Dan-zanfira/Input-Audio-Preamplifier/Layout/pcb_layout.jpg

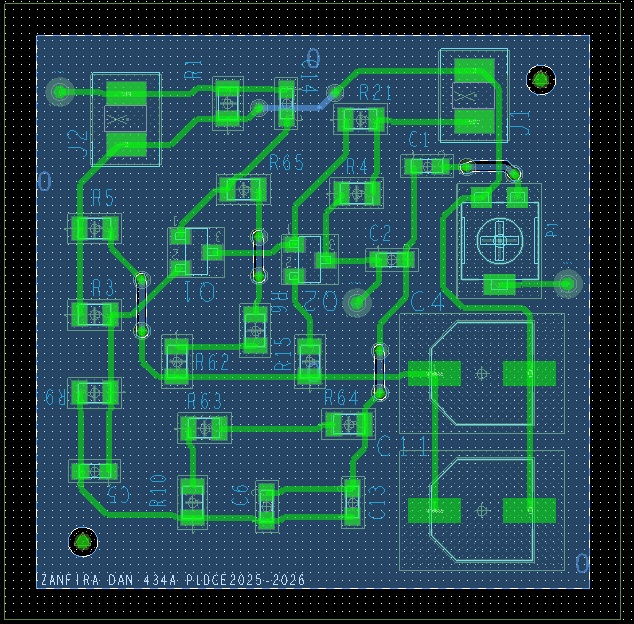
Layout/pcb_layout.jpg
