Dan-zanfira/Input-Audio-Preamplifier/Project docs/document ZANFIRA.pdf

Universitatea “Politehnica” din Bucuresti

Facultatea de Electronica , Telecomunicatii si Tehnologia Informatiei

# PROIECT 1

# PREAMPLIFICATOR AUDIO DE INTRARE

# CAPITOLUL 5

Student: ZANFIRA Dan-Constantin

Grupa:434A

Prof. coordonator: BABARADA Florin

## 1.TEMA DE PROIECTARE

Tema de proiectare reprezintă un preamplificator de audiofrecvență de intrare cu schema bloc din Figura 1.

Amplificatorul audio de intrare este compus dintr-o rețea de adaptare la intrare sursa de semnal audio fiind microfonul şi două etaje de amplificare în clasa A, respectiv etajul de intrare şi etajul de ieşire care realizează amplificarea în tensiune a semnalului.

Amplificarea globala a amplificatorului audio de intrare este stabilita de reactie negativa serie la intrare-paralel la iesire iar alimentarea celor doua etaje de amplificare este realizata de sursa de alimentare.

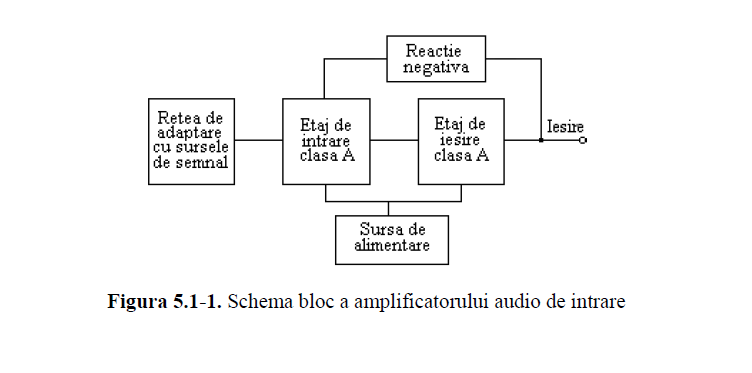
[picture p2: figure]

## 2.DATE DE INTRARE:

Principalii parametrii de intare ai amplificatorului audio sunt:
- Sensibilitatea minimă la intare Vin (2,5mV)
- Rezistența de intrare Rin(47 kOhm)
- Rezistența de ieșire maximă R0M(4 kOhm)
- Tensiunea nominală la ieșirea amplificatorului audio de putere Vn (1,4Vef)

Datele de intrare pentru proiectare sunt afisate mai jos:

Nr. | Preamplificator | Sursa de alimentare
Vin (mV) | Ri (KΩ) | R0M (KΩ) | Vn (Vef) | Io (mA) | R0M (Ω) | S0min (-)
5 | 2,5 | 47 | 4 | 1,4 | 12 | 6 | 80

## 3.SCHEMA ELECTRONICA:

Preamplificatorul este partea care influenteaza cel mai pregnant raportul semnal zgomot, caracteristica de frecventa si factorul de distorsiuni intr-un lant de amplificare de audiofrecventa.

In practica exista adesea şi alte semnale numite semnale false, care tind sa interfereze cu semnalele dorite şi acestea se numesc în general semnale de zgomot. Un obiectiv important în proiectare este realizarea unui bun raport semnal zgomot, cu toate ca zgomotul nu poate fi eliminat complet.

Un preamplificator sensibil si relativ putin zgomotos constituie o problema importanta dacă urmeaza ca la iesire zgomotul sa fie minim, deoarece orice zgomot din preamplificator este amplificat de fiecare etaj care urmeaza.

Din aceste considerente pentru intrarea microfon dinamic la care nivelul semnalului de intrare precum si raportul semnal zgomot sunt minime, sunt prevazute filtre de compensare care actioneaza prin intermediul sistemului de reactie negativa.

De asemenea, a fost introdus un filtru RC pe etajul de intrare pentru a reduce brumul de retea. Amplificarea în tensiune este realizată de etajul de intrare si cel de iesire.

Etajul de intrare este de tipul emitor comun cu sarcina distribuita si este realizat cu tranzistorul Q1. Etajul de ieşire este cuplat galvanic cu etajul de intrare si este de tip emitor comun, realizat cu tranzistorul Q2.

Având în vedere faptul că intrarea amplificatorului de putere necesită la intrare un semnal cu amplitudinea de 1,4 Vef, iar amplificatorul corector de ton sau alte etaje intermediare au amplificarea

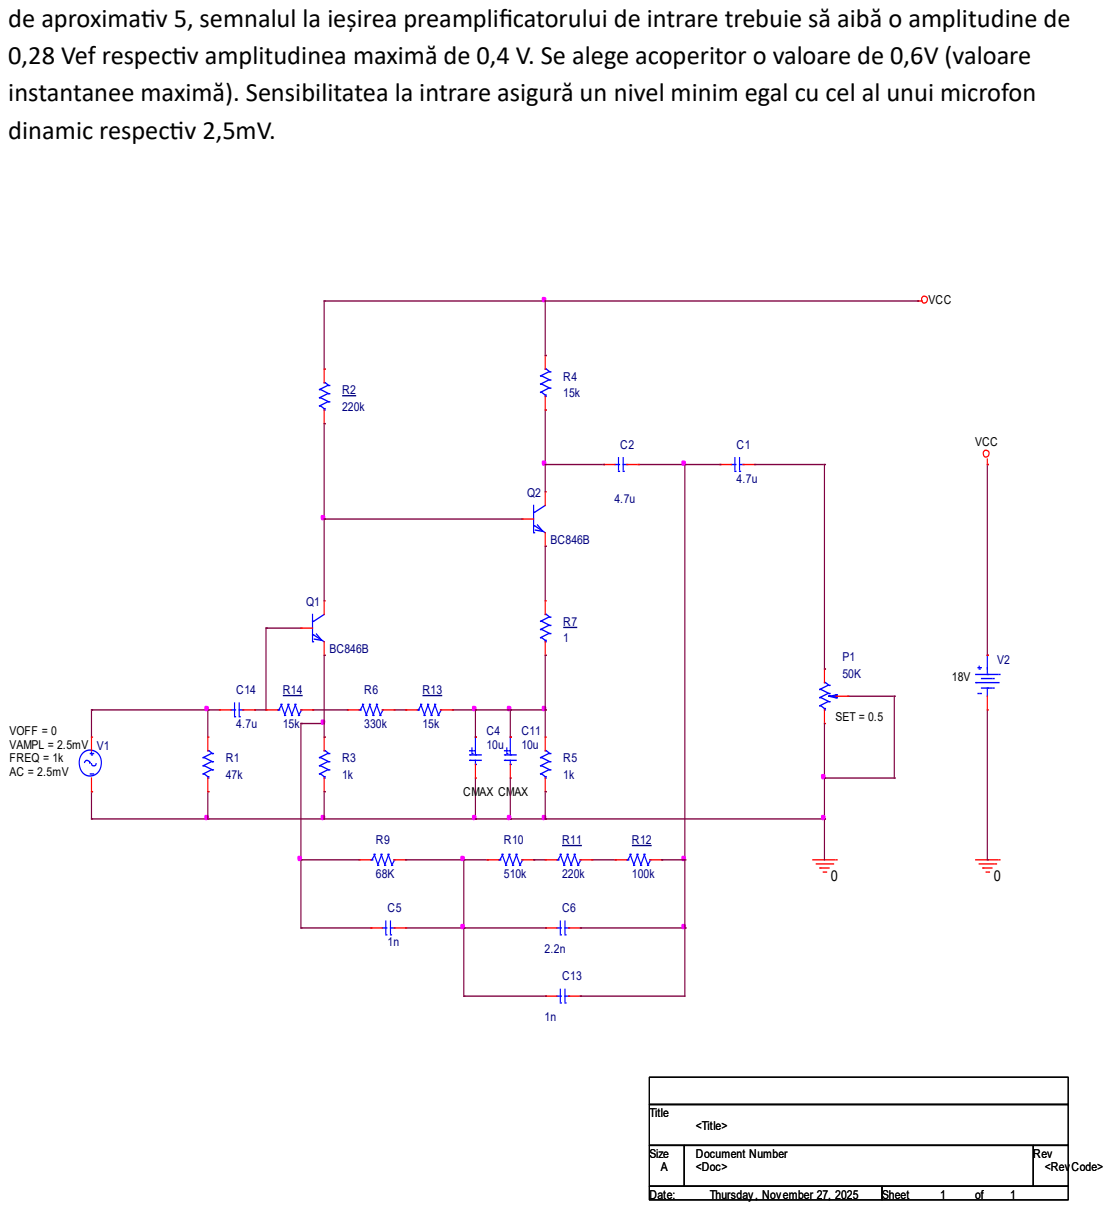
[picture p3: page 4]

de aproximativ 5, semnalul la ieşirea preamplificatorului de intrare trebuie să aibă o amplitudine de
0,28 Vef respectiv amplitudinea maximă de 0,4 V. Se alege acoperitor o valoare de 0,6V (valoare
instantanee maximă). Sensibilitatea la intrare asigură un nivel minim egal cu cel al unui microfon
dinamic respectiv 2,5mV.

## 4.ETAJELE DE AMPLIFICARE:

Avand în vedere faptul ca intrarea amplificatorului de putere necesita la intrare un semnal cu amplitudinea de 1,4 Vef, iar amplificatorul corector de ton sau alte etaje intermediare au amplificarea de aproximativ 5, semnalul la iesirea preamplificatorului de intrare trebuie sa aiba o amplitudine de 0,28 Vef respectiv amplitudinea maximă de 0,4 V. Sensibilitatea la intrare asigură un nivel minim egal cu cel al unui microfon dinamic respectiv 2,5mV.

1)Alegerea tranzistorilor Q1 si Q2:

Nivelul mic al semnalului de intrare impune alegerea pentru etajele de amplificare a unor tranzistoare cu zgomot mic de tip BC846B cu următoarele PSF-uri:

Pentru Q1, pe baza curbelor izo-F, din catalog pentru BC846B, se alege IC1 = 80 μA la care pentru rezistența generatorului Rg = 2 ÷ 20k ⇒ F ≤ 2dB. Se alege VCE1 ≅ 1,4 V. Din catalog în acest PSF rezultă:

hIE1 ≅ rBE1 ≅ 150 kΩ

hFE1 = β1 ≅ 300

hOE1 ≅ 18 μS

Pentru Q2 se alege IC2 ≅ 1mA şi VCE2 ≅ 8 V. Din catalog în acest PSF rezultă:

hIE2 ≅ rBE2 ≅ 11k

hFE2 = β2 ≅ 400

hOE2 ≅ 60 μS

2)Amplificarea in tensiune:

Amplificarea în tensiune a etajului de intrare care este de tipul emitor comun cu sarcină distribuită este:

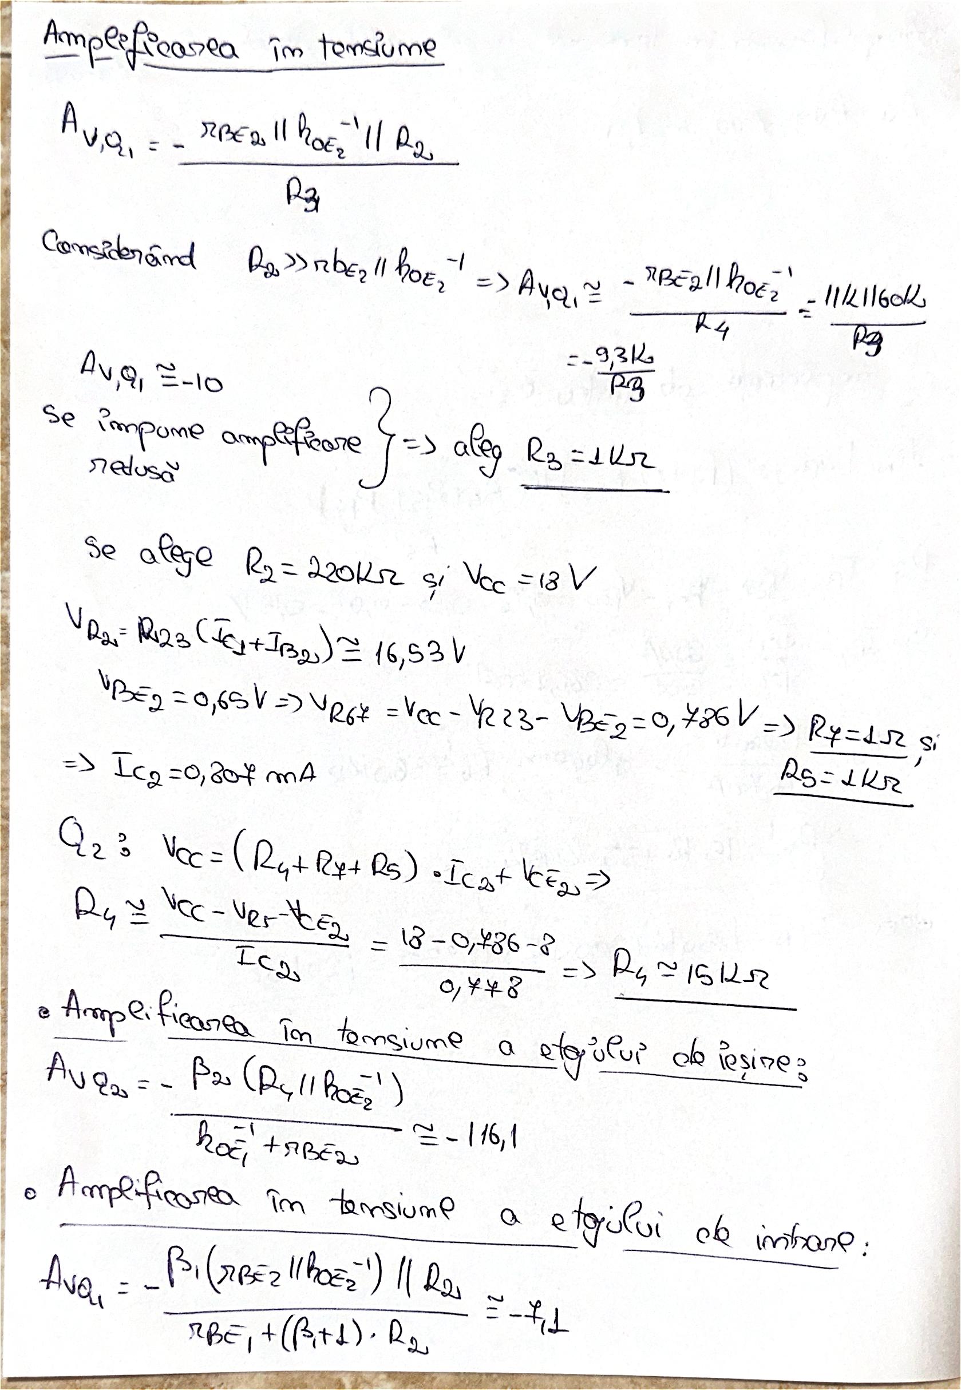
[picture p4: page 6]
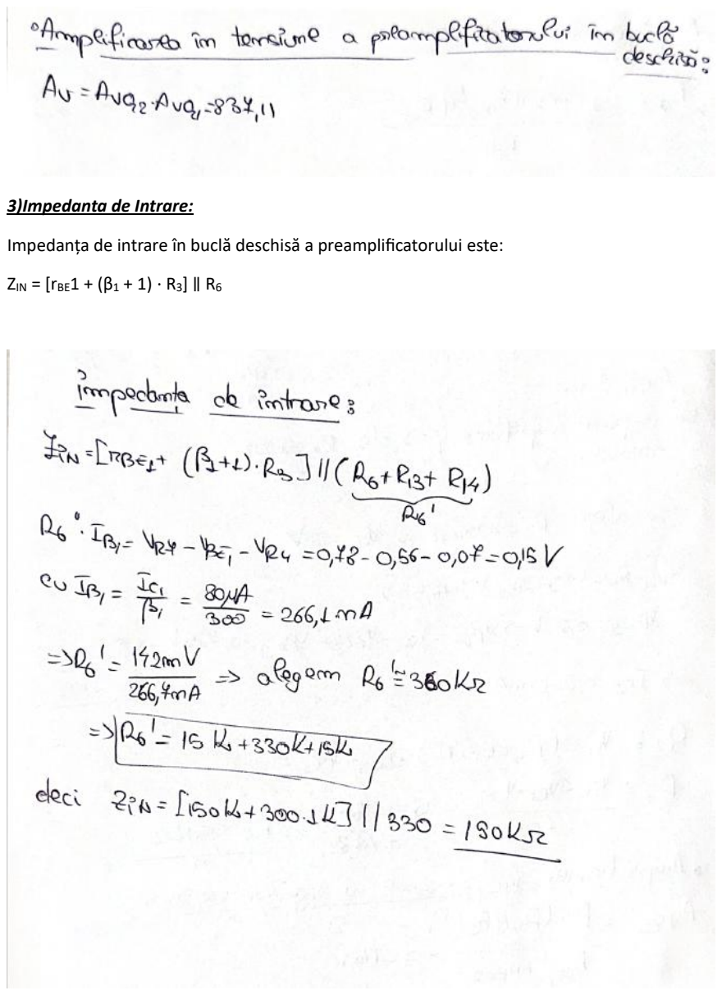
[picture p5: page 7]

3)Impedanta de Intrare:

Impedanța de intrare în buclă deschisă a preamplificatorului este:

ZIN = [rBE1 + (β1 + 1) ⋅ R3] ∥ R6

4)Dimensionarea Condensatorilor:

Din motive de stabilitate determinate grafic pe caracteristica BODE, se alege pentru polul dat de C4 la frecvența f4 ≅ 5 ÷ 10Hz (7Hz).

Rezistența văzută la bornele lui C4 este:

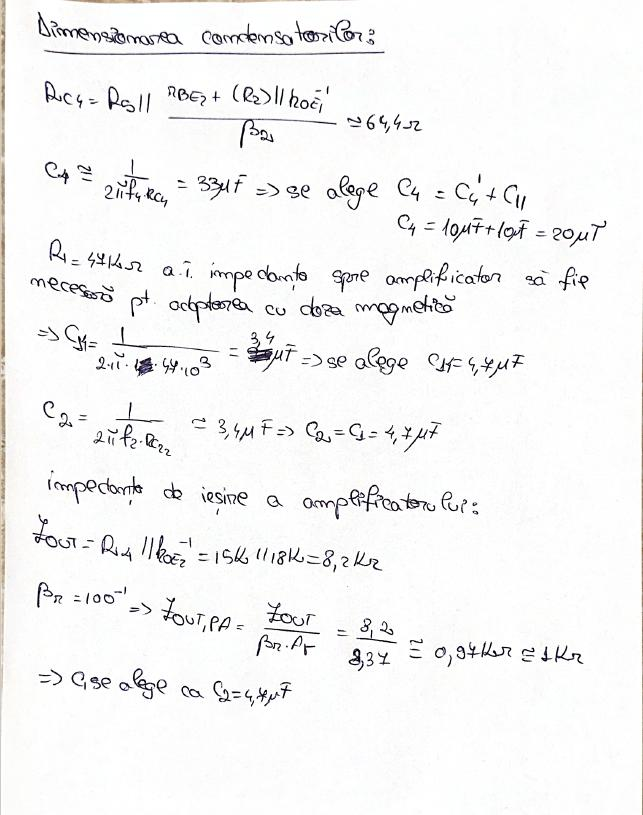
[picture p6: figure]

5)Reactia negative si retelele de adaptare:

Pentru estimarea nivelului nominal al semnalului la ieşirea preamplificatorului cunoaştem:

- Amplitudinea nominală a semnalului la intrarea în amplificatorul final Vnom= 1,4Vef
- Amplificarea circuitelor intermediare de aproximativ 5

Folosind aceste informații putem calcula: Vout,pa = 1,4Vef/ 5 =280mVef

Rețeaua de adaptare se dimensionează în raport cu acest nivel şi cu nivelul sursei de program conform tabelului:

Sursa | Rezistenta de intrare Ri[kΩ] | Sensibiliate Vin[mV]
Microfon | 47 kΩ | 2,5mVef

Pentru intrarea de microfon şi pick-up magnetic se proiectează o rețea de reacție

egalizatoare, care să corecteze caracteristica de frecvență a dozei magnetice. S-a

adoptat corecția după norma R.I.A.A, în care se impun următoarele constante de

timp: t1=318 s, t2=75 s, t3=3180 s.

Considerand o reactive sufficient de puternica astfel incat sa se poate scrie :Avr=1/Br si avand Br=R4/Z(w), unde Z este impedanta grupului format din R9,R10,C5,C6=>

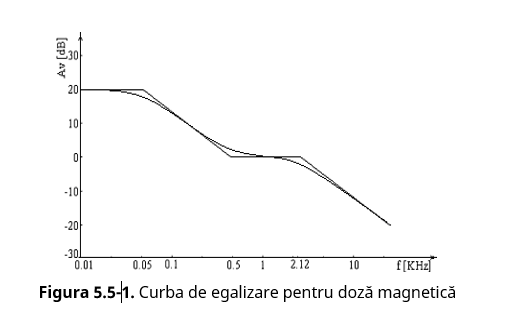
[picture p7: figure]

Z(ω) este de forma: Z(ω)=B1+pt1(1+pt2)(1+pt3) ,unde:

B=R9+R10

t1=(C6+C7)R9∗R10
R9+R10
t2=C7∙R10

t3=C6∙R9

R9≅10∙R10

C6=3,4∙C7

Practic la 1 kHz se poate considera Z(ω)≅R10 şi atunci AV,r,1 KHz≅R10R4. Amplificarea necesară este:

AV,r,1 KHz=280 mV/2,5 mV=112

Pentru a asigura impedanța de intrare impusă de 47 kΩ se introduce la intrarea preamplificatorului rezistența R1 care şuntează intrarea.

Pentru frecvența f=1 kHz-> βrAV =

837.11
90

= 9.3
Impedanța de intrare în preamplificator, cu reacție este: ZIN,r = βr ∙ AV ⋅ ZIN = 2,33 MΩ.

### Impedanța de intrare globală în preamplificatorul de intrare este:

ZIN,PA = R1 ∥ ZIN,r = 47 kΩ ∥ 2,33 MΩ = 47 kΩ ⇒ ZIN,PA = 47kΩ

## 5.SIMULAREA FUNCTIONARII:

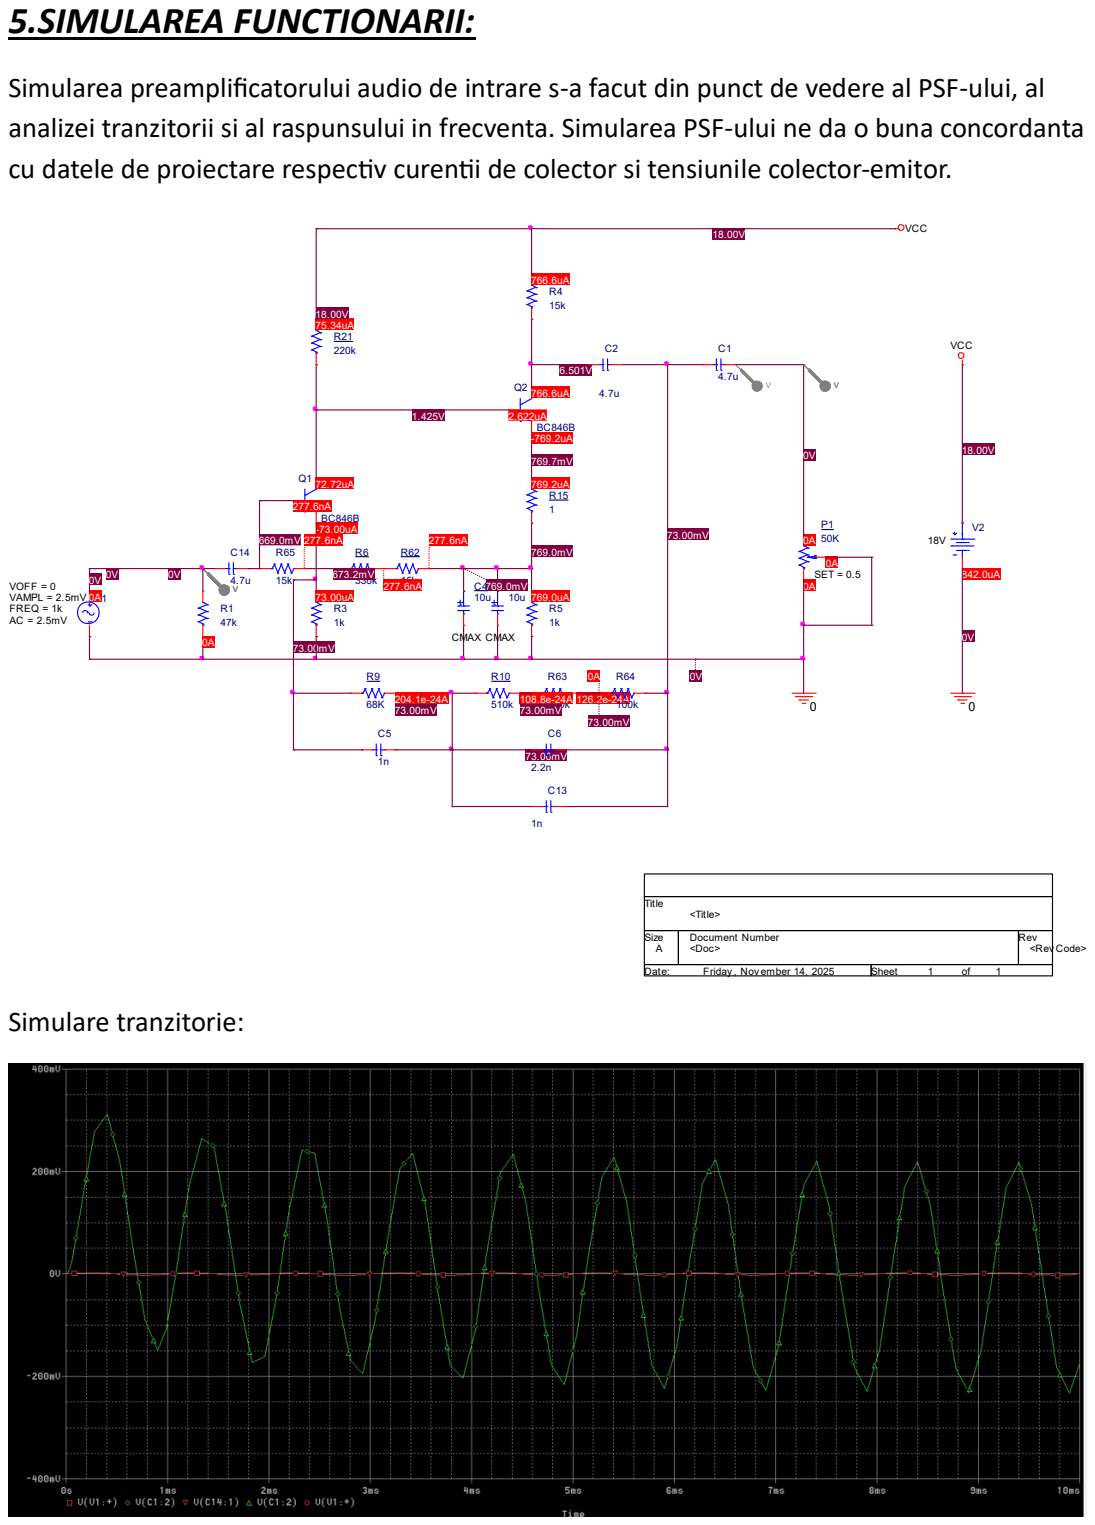
[picture p8: page 11]

Simularea preamplificatorului audio de intrare s-a facut din punct de vedere al PSF-ului, al
analizei tranzitorii si al raspunsului in frecventa. Simularea PSF-ului ne da o buna concordanta
cu datele de proiectare respectiv curentii de colector si tensiunile colector-emitor.

Simulare in frecventa:

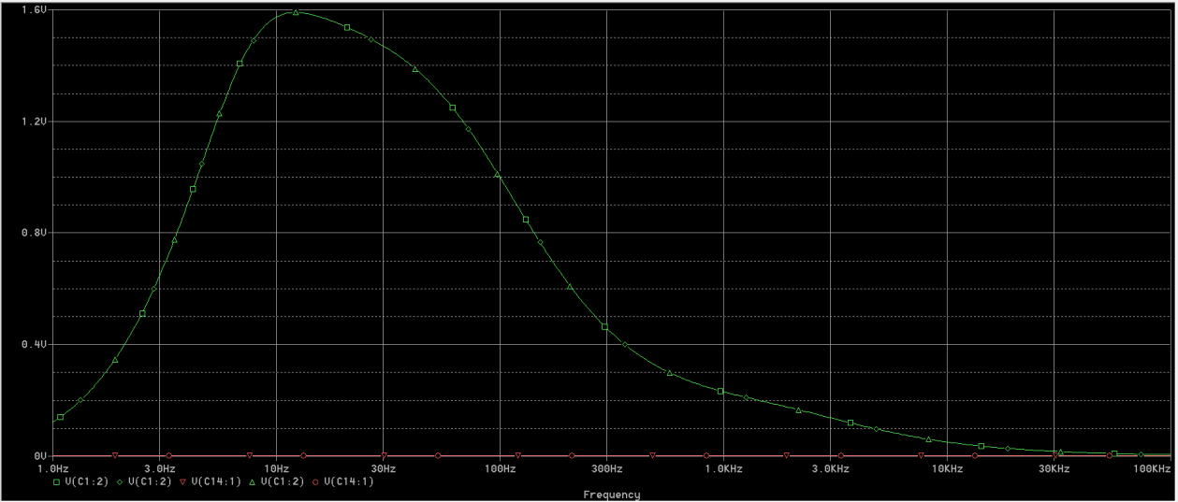
[picture p9: figure]

## 6.LISTA COMPONENTELOR:

Lista componentelor amplificatorului audio de intrare:

REZISTENTE:

R1=47kΩ ± 5%

R3=1kΩ ± 5%

R5=1kΩ ± 5%

R14=15kΩ ± 5%

R13=15kΩ ± 5%

R6=330kΩ ± 5%

R9=68kΩ ± 5%

R10=510kΩ ± 5%

R11=220kΩ ± 5%

R12=100kΩ ± 5%

R7=1Ω ± 5%

R2=220kΩ ± 5%

R4=15kΩ ± 5%

P=50kΩ SET=0.5

Ec=18V

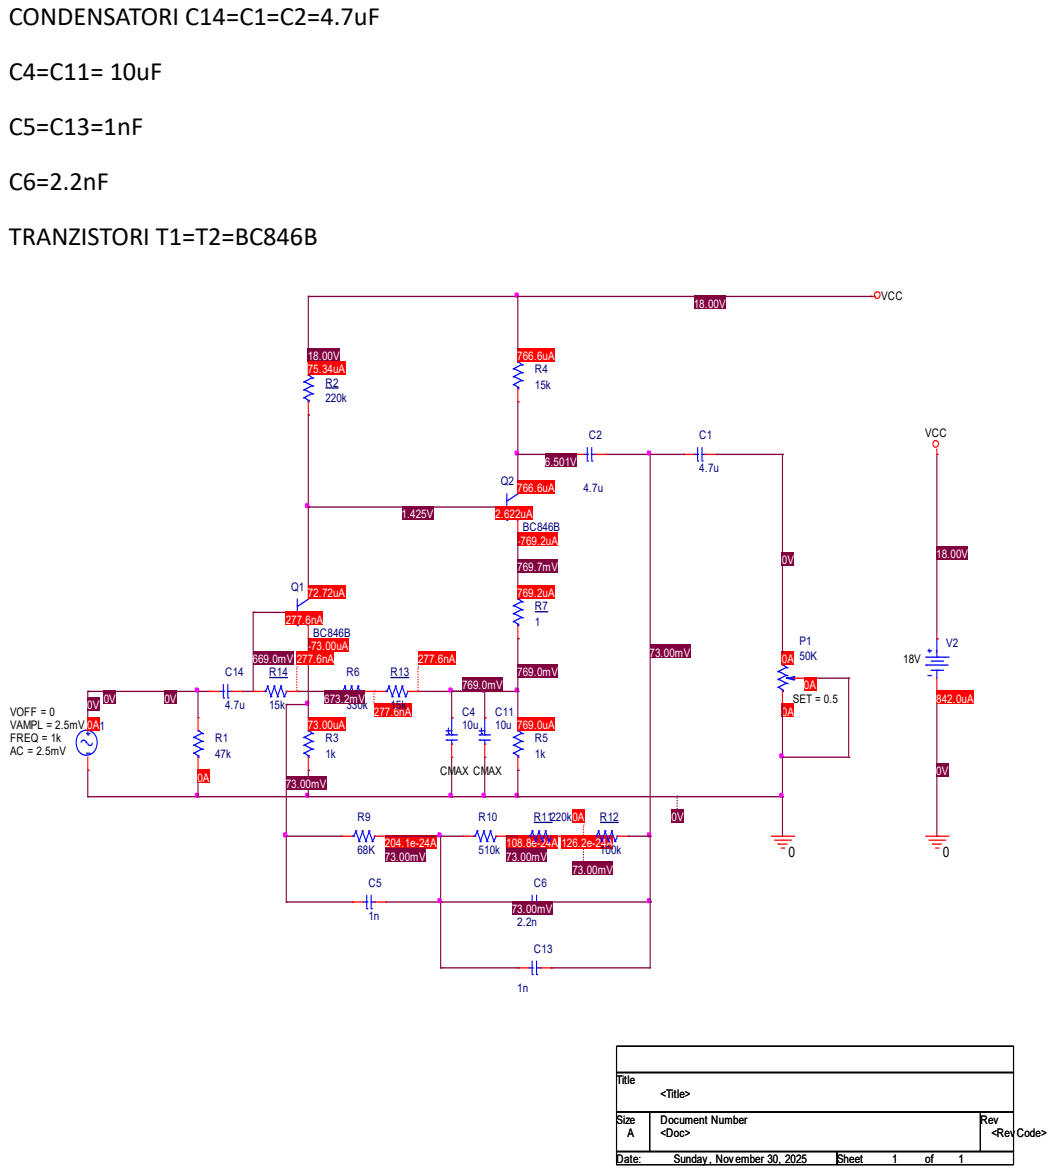
[picture p10: page 13]
