Dan-zanfira/Input-Audio-Preamplifier/Simulations/simulare timp.jpg

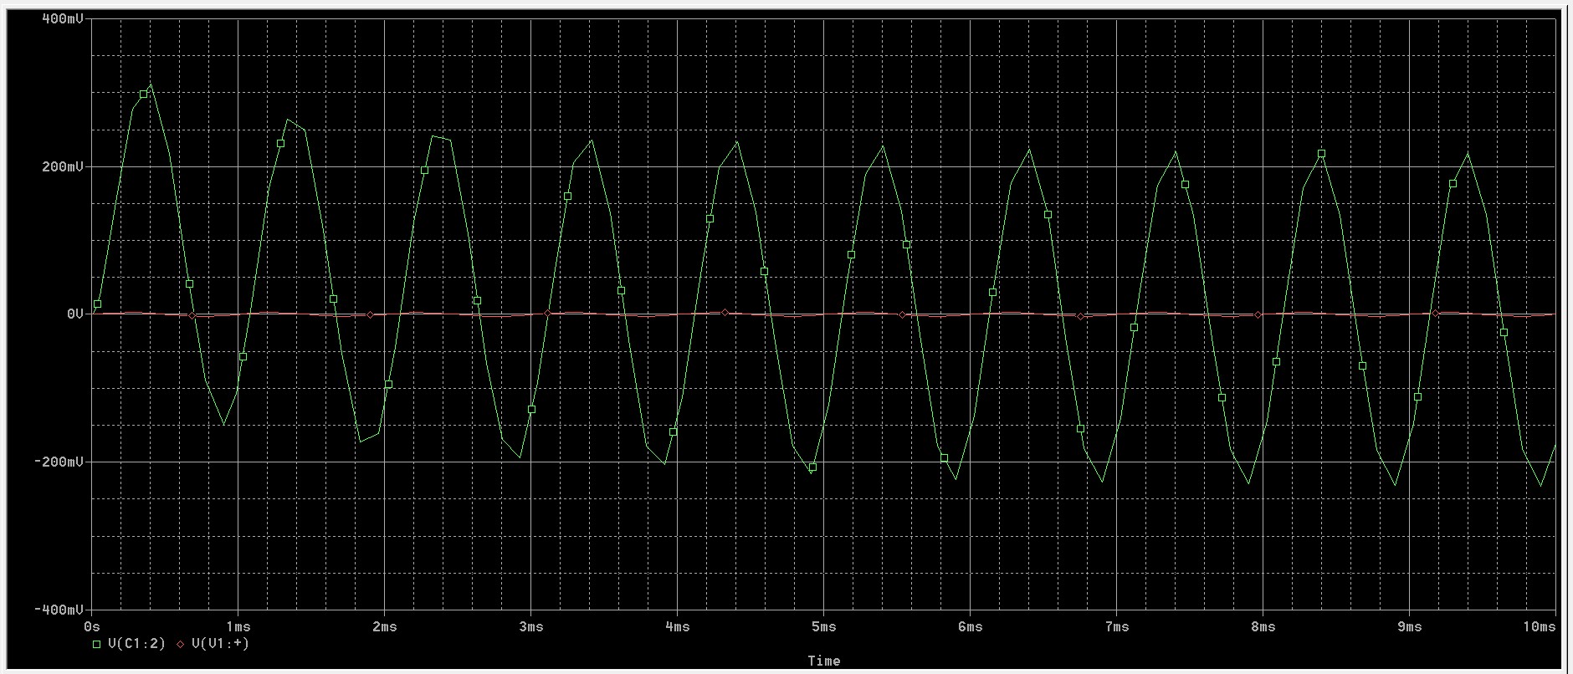
Simulations/simulare timp.jpg
