Dan-zanfira/Input-Audio-Preamplifier/Simulations/simulare_frecventa.jpg

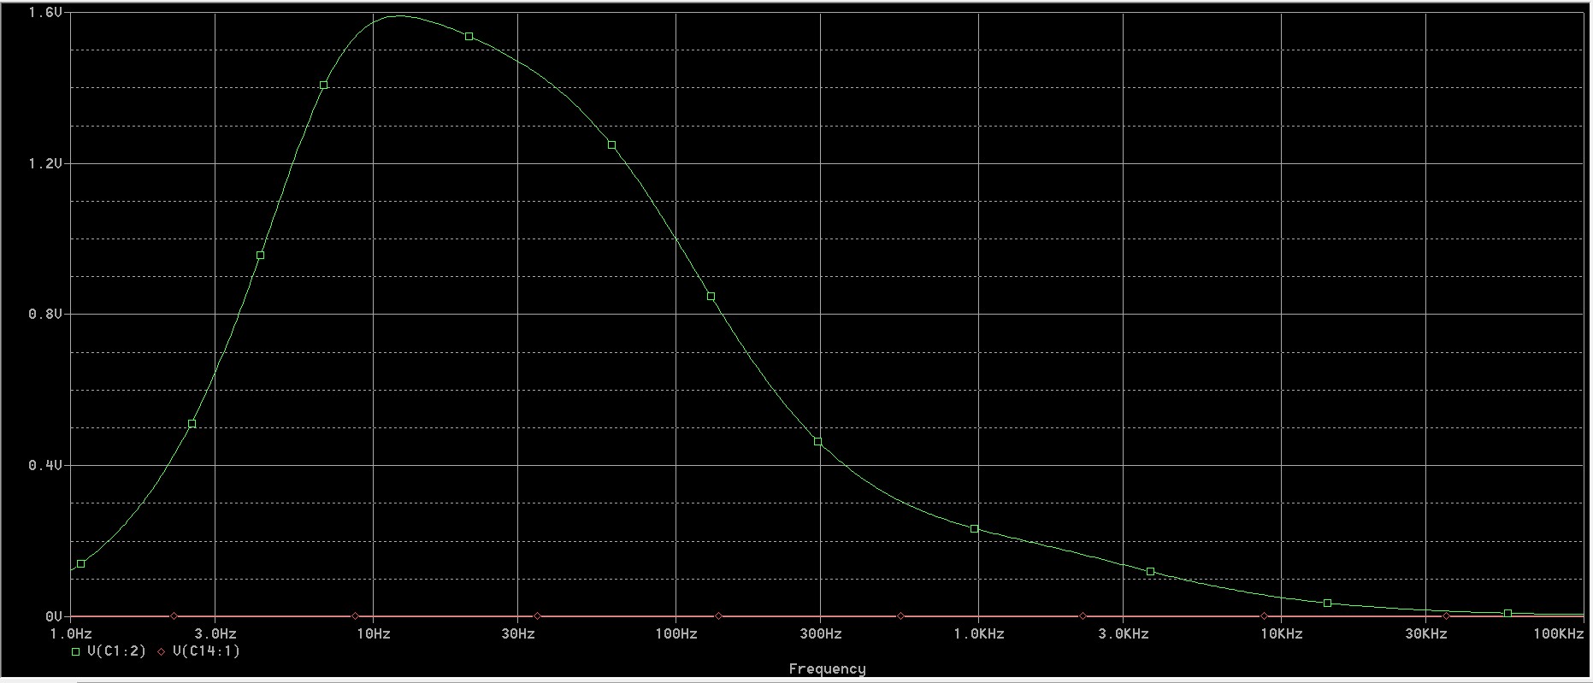
Simulations/simulare_frecventa.jpg
