Dan-zanfira/Input-Audio-Preamplifier/Bill_of_materials/BOM_ZANFIRA_DAN_434Aa.xlsx

Nr. Crt. | Nume | Catalog | Cod distrib | Nume prod | Prod | Clasă | Descriere | Distribuitor | Cantitate
1 | 4.7uF | (LINK) (https://www.tme.eu/ro/details/cl21a475kaqnnng/condensatoare-mlcc-smd-0805/samsung/) | CL21A475KAQNNNG | CL21A475KAQNNNG | SAMSUNG | condensator | Condensator: ceramic; MLCC; 4,7uF; 25V; X5R; ±10%; SMD; 0805 | TME ROMANIA | 3
2 | 10uF | (LINK) (https://www.tme.eu/ro/details/eee1ha100sp/condensatoare-electrolitice-smd/panasonic/) | EEE1HA100SP | EEE1HA100SP | PANASONIC | condensator | Condensator: electrolitic; SMD; 10uF; 50VDC; Ø6,3x5,4mm; ±20%; S | TME ROMANIA | 2
3 | 1nF | (LINK) (https://www.tme.eu/ro/details/cc0805jrnpo9102/condensatoare-mlcc-smd/yageo/cc0805jrnpo9bn102/) | CL21C102JBCNNNC | CL21C102JBCNNNC | SAMSUNG | condensator | Condensator: ceramic; MLCC; 1nF; 50V; C0G (NP0); ±5%; SMD; 0805 | TME ROMANIA | 2
4 | 2.2nF | (LINK) (https://www.tme.eu/ro/details/cl21b222jbannnc/condensatoare-mlcc-smd-0805/samsung/) | CL21B222JBANNNC | CL21B222JBANNNC | SAMSUNG | condensator | Condensator: ceramic; MLCC; 2,2nF; 50V; X7R; ±5%; SMD; 0805 | TME ROMANIA | 1
5 | 50k | (LINK) (http://www.tme.eu/ro/details/3314g-1-503e/trimere-smd-cu-o-singura-tura/bourns/) | 3314G-1-503E | 3314G-1-503E | BOURNS | potențiometru | Potenţiometru: de montare; singură tură,orizontal; 50kΩ; 250mW | TME ROMANIA | 1
6 | NPN | (LINK) (https://www.tme.eu/ro/details/bc846b-dio/tranzistori-smd-npn/diotec-semiconductor/bc846b/) | BC846B | BC846B | DIOTEC | tranzistor bipolar | Tranzistor: NPN; bipolar; 65V; 0,1A; 250mW; SOT23 | TME ROMANIA | 2
7 | 47k | (LINK) (http://www.tme.eu/ro/details/smd0805-47k/rezistente-smd-0805/royal-ohm/0805s8j0473t5e/) | SMD0805-47K-5% | 0805S8J0473T5E | ROYAL OHM | rezistor | Rezistor: thick film; SMD; 0805; 47kΩ; 0,125W; ±5%; 150V; -55÷125°C | TME ROMANIA | 1
8 | 1k | (LINK) (https://www.tme.eu/ro/details/smd0805-1k/rezistente-smd-0805/royal-ohm/0805s8j0102t5e/) | SMD0805-1K-5% | 0805S8J0102T5E | ROYAL OHM | rezistor | Rezistor: thick film; SMD; 0805; 1kΩ; 0,125W; ±5%; 150V; -55÷125°C | TME ROMANIA | 2
9 | 15k | (LINK) (https://www.tme.eu/ro/details/smd0805-15k/rezistente-smd-0805/royal-ohm/0805s8j0153t5e/) | SMD0805-15K-5% | 0805S8J0153T5E | ROYAL OHM | rezistor | Rezistor: thick film; SMD; 0805; 15kΩ; 0,125W; ±5%; 150V; -55÷125°C | TME ROMANIA | 3
10 | 330k | (LINK) (https://www.tme.eu/ro/details/smd0805-330k/rezistente-smd-0805/royal-ohm/0805s8j0334t5e/) | SMD0805-330K-5% | 0805S8J0334T5E | ROYAL OHM | rezistor | Rezistor: thick film; SMD; 0805; 330kΩ; 0,125W; ±5%; 150V; -55÷125°C | TME ROMANIA | 1
11 | 68k | (LINK) (https://www.tme.eu/ro/details/smd0805-68k/rezistente-smd-0805/royal-ohm/0805s8j0683t5e/) | SMD0805-68K-5% | 0805S8J0683T5E | ROYAL OHM | rezistor | Rezistor: thick film; SMD; 0805; 68kΩ; 0,125W; ±5%; 150V; -55÷125°C | TME ROMANIA | 1
12 | 510k | (LINK) (https://www.tme.eu/ro/details/smd0805-510k/rezistente-smd-0805/royal-ohm/0805s8j0514t5e/) | SMD0805-510K-5% | 0805S8J0514T5E | ROYAL OHM | rezistor | Rezistor: thick film; SMD; 0805; 510kΩ; 0,125W; ±5%; 150V; -55÷125°C | TME ROMANIA | 1
13 | 1 | (LINK) (https://www.tme.eu/ro/details/smd0805-1r/rezistente-smd-0805/royal-ohm/0805s8j010jt5e/) | SMD0805-1R-5% | 0805S8J010JT5E | ROYAL OHM | rezistor | Rezistor: thick film; SMD; 0805; 1Ω; 0,125W; ±5%; 150V; -55÷125°C | TME ROMANIA | 1
14 | 220k | (LINK) (https://www.tme.eu/ro/details/smd0805-220k/rezistente-smd-0805/royal-ohm/0805s8j0224t5e/) | SMD0805-220K-5% | 0805S8J0224T5E | ROYAL OHM | rezistor | Rezistor: thick film; SMD; 0805; 220kΩ; 0,125W; ±5%; 150V; -55÷125°C | TME ROMANIA | 2
15 | 100k | (LINK) (https://www.tme.eu/ro/details/smd0805-100k/rezistente-smd-0805/royal-ohm/0805s8j0104t5e/) | SMD0805-100K-5% | 0805S8J0104T5E | ROYAL OHM | rezistor | Rezistor: thick film; SMD; 0805; 100kΩ; 0,125W; ±5%; 150V; -55÷125°C | TME ROMANIA | 1
16 | Conn2p | (LINK) (http://www.tme.eu/ro/details/zl301-40p/pini-cu-benzi-si-soclu/ninigi/) | ZL301-40P | ZL301-40P | NINIGI | Sir pini, pas 2,54mm, SMD | Conector: şiruri pini; şir pini; tată; PIN: 40; SMT; verticală; 1A | TME ROMANIA | 2
