Dan-zanfira/Input-Audio-Preamplifier/(list of files, drawings)

Other design files:
PROIECT_SCHEMATIC_CONECTORI_FINAL/PCB_ZANFIRA_SCHEMATIC.DSN
PROIECT_SCHEMATIC_CONECTORI_FINAL/pcb_zanfira_schematic.opj
